woreno/Apple-II-compatible/Motherboard and other boards.png

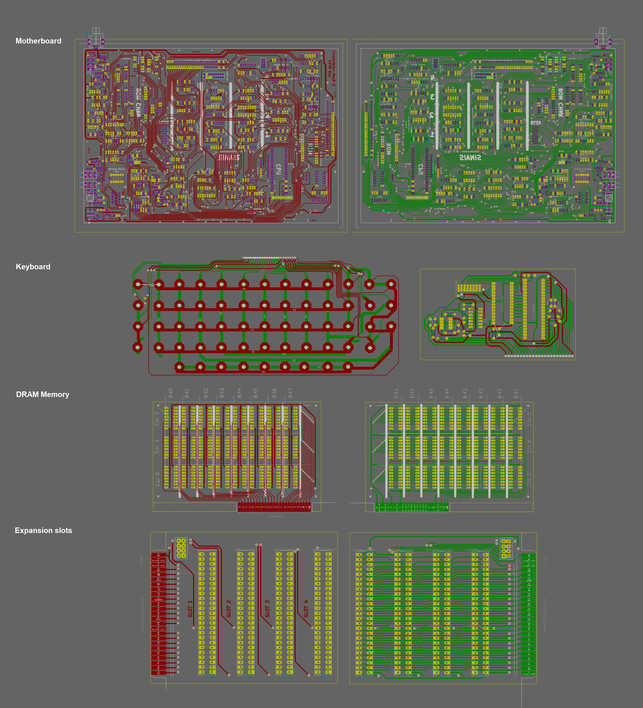
Motherboard and other boards.png
