woreno/Apple-II-compatible/KICAD/appleii-slots/appleii-slots.kicad_pcb

## KiCad design KICAD/appleii-slots/appleii-slots.kicad_pcb (2026-11-09)

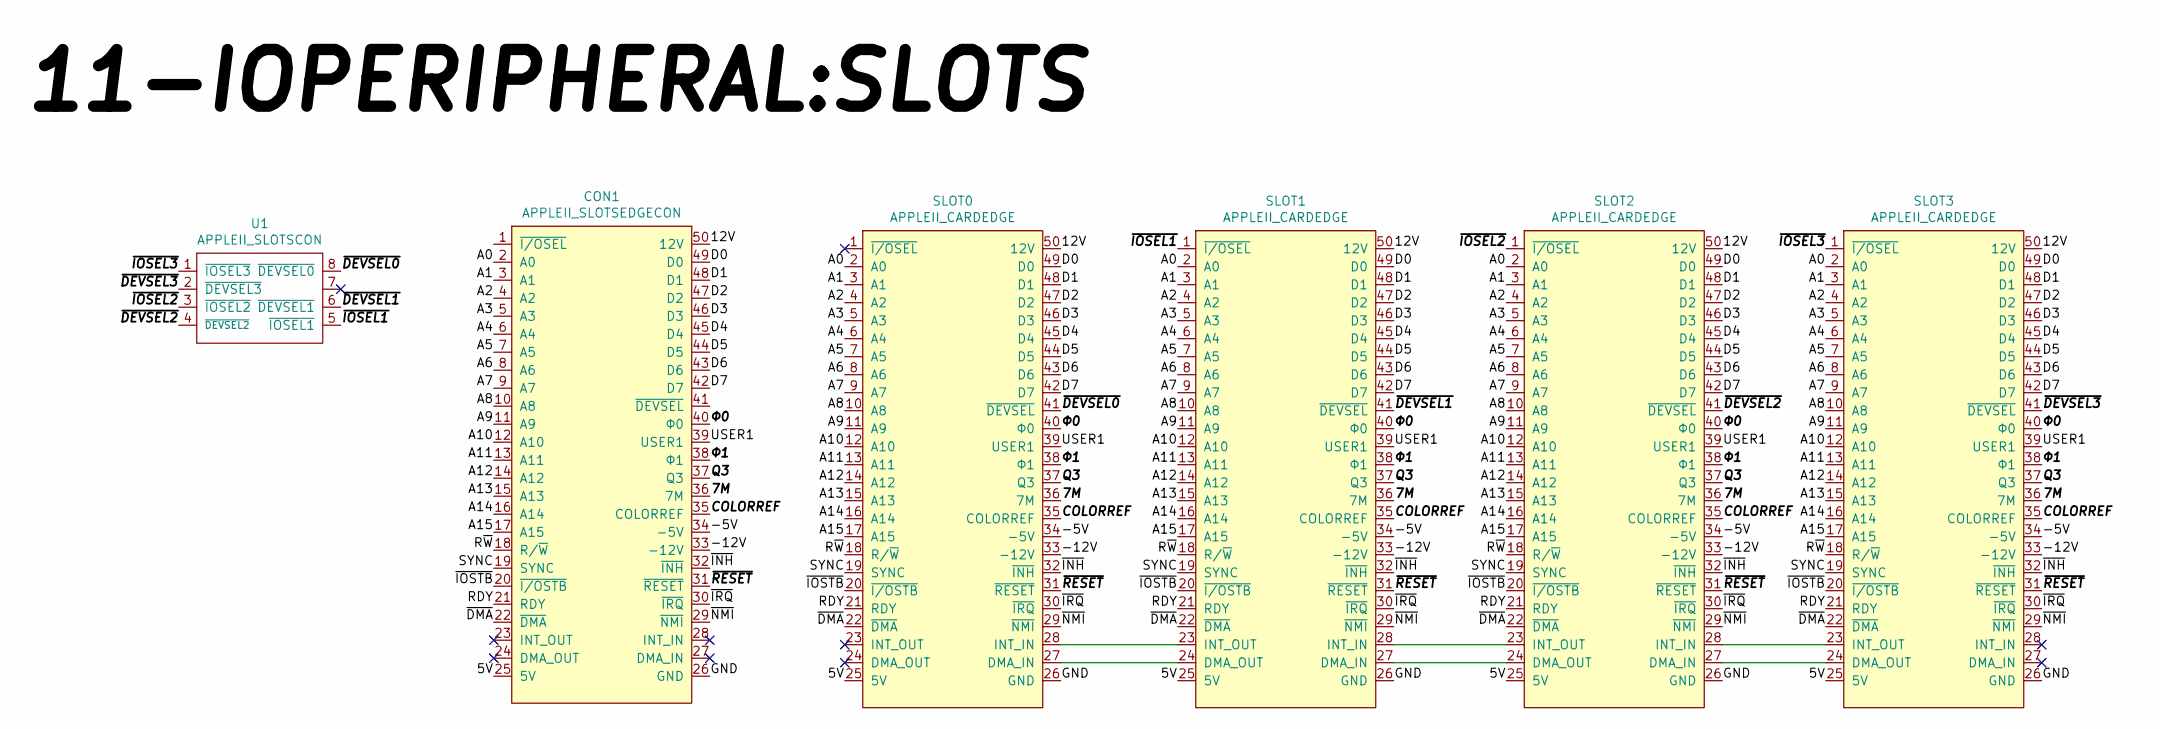
[picture p2: schematic appleii-slots.sch]

Parts:
CON1: APPLEII_SLOTSEDGECON; Apple_8bit_edge
SLOT0, SLOT1, SLOT2, SLOT3: APPLEII_CARDEDGE; Conector2x25_Oval_tinny
U1: APPLEII_SLOTSCON; conetor_2x04_P2.54

Connections:
/5V: CON1.25 (5V), SLOT0.25 (5V), SLOT1.25 (5V), SLOT2.25 (5V), SLOT3.25 (5V)
/7M: CON1.36 (7M), SLOT0.36 (7M), SLOT1.36 (7M), SLOT2.36 (7M), SLOT3.36 (7M)
/12V: CON1.50 (12V), SLOT0.50 (12V), SLOT1.50 (12V), SLOT2.50 (12V), SLOT3.50 (12V)
/-5V: CON1.34 (-5V), SLOT0.34 (-5V), SLOT1.34 (-5V), SLOT2.34 (-5V), SLOT3.34 (-5V)
/-12V: CON1.33 (-12V), SLOT0.33 (-12V), SLOT1.33 (-12V), SLOT2.33 (-12V), SLOT3.33 (-12V)
/A0: CON1.2 (A0), SLOT0.2 (A0), SLOT1.2 (A0), SLOT2.2 (A0), SLOT3.2 (A0)
/A1: CON1.3 (A1), SLOT0.3 (A1), SLOT1.3 (A1), SLOT2.3 (A1), SLOT3.3 (A1)
/A2: CON1.4 (A2), SLOT0.4 (A2), SLOT1.4 (A2), SLOT2.4 (A2), SLOT3.4 (A2)
/A3: CON1.5 (A3), SLOT0.5 (A3), SLOT1.5 (A3), SLOT2.5 (A3), SLOT3.5 (A3)
/A4: CON1.6 (A4), SLOT0.6 (A4), SLOT1.6 (A4), SLOT2.6 (A4), SLOT3.6 (A4)
/A5: CON1.7 (A5), SLOT0.7 (A5), SLOT1.7 (A5), SLOT2.7 (A5), SLOT3.7 (A5)
/A6: CON1.8 (A6), SLOT0.8 (A6), SLOT1.8 (A6), SLOT2.8 (A6), SLOT3.8 (A6)
/A7: CON1.9 (A7), SLOT0.9 (A7), SLOT1.9 (A7), SLOT2.9 (A7), SLOT3.9 (A7)
/A8: CON1.10 (A8), SLOT0.10 (A8), SLOT1.10 (A8), SLOT2.10 (A8), SLOT3.10 (A8)
/A9: CON1.11 (A9), SLOT0.11 (A9), SLOT1.11 (A9), SLOT2.11 (A9), SLOT3.11 (A9)
/A10: CON1.12 (A10), SLOT0.12 (A10), SLOT1.12 (A10), SLOT2.12 (A10), SLOT3.12 (A10)
/A11: CON1.13 (A11), SLOT0.13 (A11), SLOT1.13 (A11), SLOT2.13 (A11), SLOT3.13 (A11)
/A12: CON1.14 (A12), SLOT0.14 (A12), SLOT1.14 (A12), SLOT2.14 (A12), SLOT3.14 (A12)
/A13: CON1.15 (A13), SLOT0.15 (A13), SLOT1.15 (A13), SLOT2.15 (A13), SLOT3.15 (A13)
/A14: CON1.16 (A14), SLOT0.16 (A14), SLOT1.16 (A14), SLOT2.16 (A14), SLOT3.16 (A14)
/A15: CON1.17 (A15), SLOT0.17 (A15), SLOT1.17 (A15), SLOT2.17 (A15), SLOT3.17 (A15)
/COLORREF: CON1.35 (COLORREF), SLOT0.35 (COLORREF), SLOT1.35 (COLORREF), SLOT2.35 (COLORREF), SLOT3.35 (COLORREF)
/D0: CON1.49 (D0), SLOT0.49 (D0), SLOT1.49 (D0), SLOT2.49 (D0), SLOT3.49 (D0)
/D1: CON1.48 (D1), SLOT0.48 (D1), SLOT1.48 (D1), SLOT2.48 (D1), SLOT3.48 (D1)
/D2: CON1.47 (D2), SLOT0.47 (D2), SLOT1.47 (D2), SLOT2.47 (D2), SLOT3.47 (D2)
/D3: CON1.46 (D3), SLOT0.46 (D3), SLOT1.46 (D3), SLOT2.46 (D3), SLOT3.46 (D3)
/D4: CON1.45 (D4), SLOT0.45 (D4), SLOT1.45 (D4), SLOT2.45 (D4), SLOT3.45 (D4)
/D5: CON1.44 (D5), SLOT0.44 (D5), SLOT1.44 (D5), SLOT2.44 (D5), SLOT3.44 (D5)
/D6: CON1.43 (D6), SLOT0.43 (D6), SLOT1.43 (D6), SLOT2.43 (D6), SLOT3.43 (D6)
/D7: CON1.42 (D7), SLOT0.42 (D7), SLOT1.42 (D7), SLOT2.42 (D7), SLOT3.42 (D7)
/GND: CON1.26 (GND), SLOT0.26 (GND), SLOT1.26 (GND), SLOT2.26 (GND), SLOT3.26 (GND)
/Q3: CON1.37 (Q3), SLOT0.37 (Q3), SLOT1.37 (Q3), SLOT2.37 (Q3), SLOT3.37 (Q3)
/RDY: CON1.21 (RDY), SLOT0.21 (RDY), SLOT1.21 (RDY), SLOT2.21 (RDY), SLOT3.21 (RDY)
/R~W: CON1.18 (R/~W), SLOT0.18 (R/~W), SLOT1.18 (R/~W), SLOT2.18 (R/~W), SLOT3.18 (R/~W)
/SYNC: CON1.19 (SYNC), SLOT0.19 (SYNC), SLOT1.19 (SYNC), SLOT2.19 (SYNC), SLOT3.19 (SYNC)
/USER1: CON1.39 (USER1), SLOT0.39 (USER1), SLOT1.39 (USER1), SLOT2.39 (USER1), SLOT3.39 (USER1)
/~DEVSEL0: SLOT0.41 (~DEVSEL), U1.8 (~DEVSEL0)
/~DEVSEL1: SLOT1.41 (~DEVSEL), U1.6 (~DEVSEL1)
/~DEVSEL2: SLOT2.41 (~DEVSEL), U1.4 (~DEVSEL2)
/~DEVSEL3: SLOT3.41 (~DEVSEL), U1.2 (~DEVSEL3)
/~DMA: CON1.22 (~DMA), SLOT0.22 (~DMA), SLOT1.22 (~DMA), SLOT2.22 (~DMA), SLOT3.22 (~DMA)
/~INH: CON1.32 (~INH), SLOT0.32 (~INH), SLOT1.32 (~INH), SLOT2.32 (~INH), SLOT3.32 (~INH)
/~IOSEL1: SLOT1.1 (~I/OSEL), U1.5 (~IOSEL1)
/~IOSEL2: SLOT2.1 (~I/OSEL), U1.3 (~IOSEL2)
/~IOSEL3: SLOT3.1 (~I/OSEL), U1.1 (~IOSEL3)
/~IOSTB: CON1.20 (~I/OSTB), SLOT0.20 (~I/OSTB), SLOT1.20 (~I/OSTB), SLOT2.20 (~I/OSTB), SLOT3.20 (~I/OSTB)
/~IRQ: CON1.30 (~IRQ), SLOT0.30 (~IRQ), SLOT1.30 (~IRQ), SLOT2.30 (~IRQ), SLOT3.30 (~IRQ)
/~NMI: CON1.29 (~NMI), SLOT0.29 (~NMI), SLOT1.29 (~NMI), SLOT2.29 (~NMI), SLOT3.29 (~NMI)
/~RESET: CON1.31 (~RESET), SLOT0.31 (~RESET), SLOT1.31 (~RESET), SLOT2.31 (~RESET), SLOT3.31 (~RESET)
/Φ0: CON1.40 (Φ0), SLOT0.40 (Φ0), SLOT1.40 (Φ0), SLOT2.40 (Φ0), SLOT3.40 (Φ0)
/Φ1: CON1.38 (Φ1), SLOT0.38 (Φ1), SLOT1.38 (Φ1), SLOT2.38 (Φ1), SLOT3.38 (Φ1)
unnamed: SLOT0.27 (DMA_IN), SLOT1.24 (DMA_OUT)
unnamed: SLOT0.28 (INT_IN), SLOT1.23 (INT_OUT)
unnamed: SLOT1.27 (DMA_IN), SLOT2.24 (DMA_OUT)
unnamed: SLOT1.28 (INT_IN), SLOT2.23 (INT_OUT)
unnamed: SLOT2.27 (DMA_IN), SLOT3.24 (DMA_OUT)
unnamed: SLOT2.28 (INT_IN), SLOT3.23 (INT_OUT)

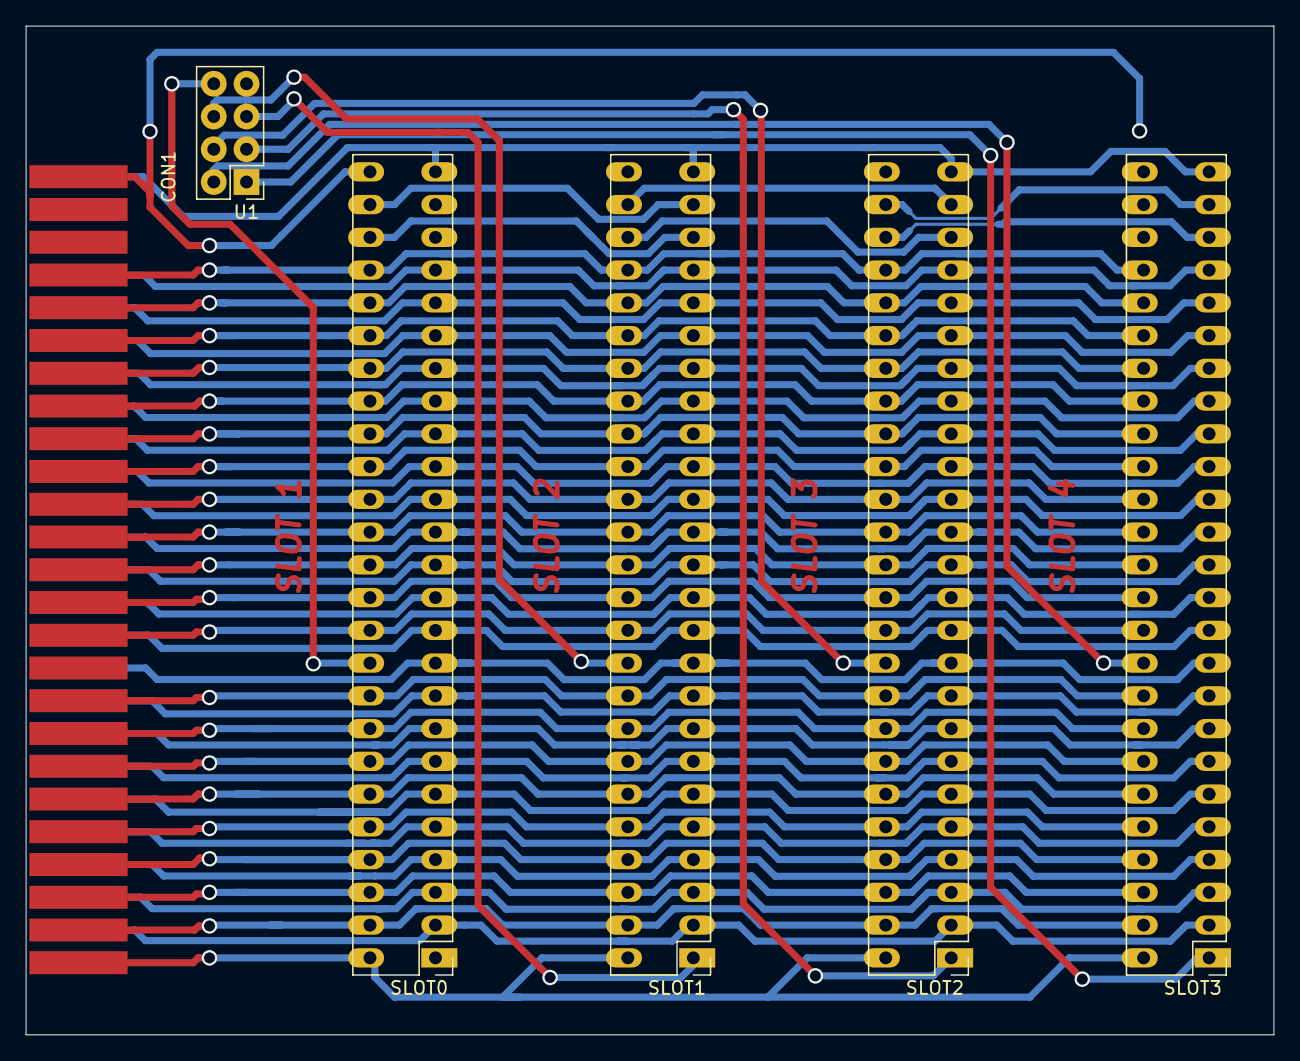
[picture p3: board appleii-slots.kicad_pcb from above]

Board: 2 copper layers, 96.8 x 78.2 mm, 6 parts (0 on the bottom side), 57 nets.
