woreno/Apple-II-compatible/KICAD/appleii-mem/appleii-mem.kicad_pcb

## KiCad design KICAD/appleii-mem/appleii-mem.kicad_pcb (2026-11-09)

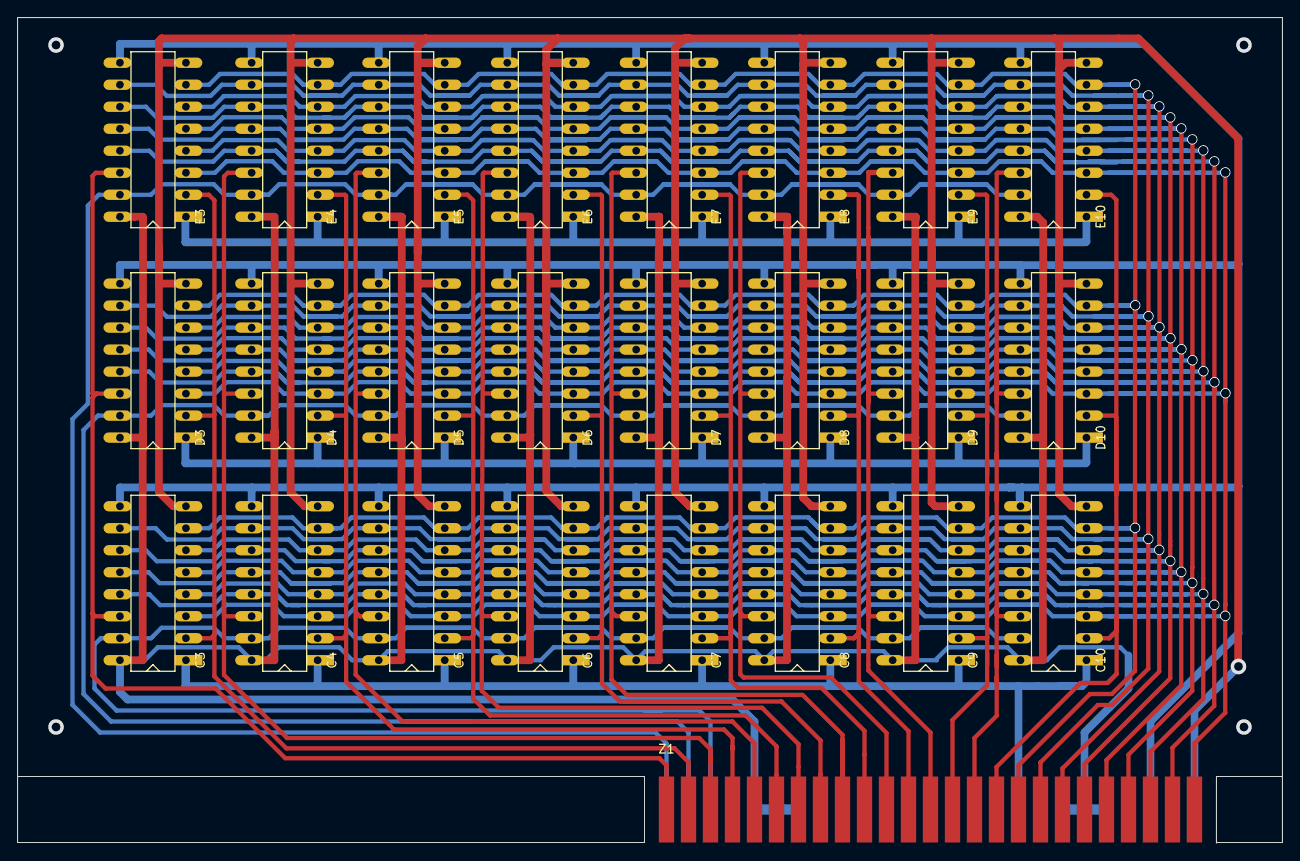
[picture p4: board appleii-mem.kicad_pcb from above]

Board: 2 copper layers, 146.0 x 95.3 mm, 25 parts (0 on the bottom side), 32 nets.

Parts:
C3, C4, C5, C6, C7, C8, C9, C10: DRAM_4116_2KB_DIP16; standard_DIP_16OvalPins
D3, D4, D5, D6, D7, D8, D9, D10: DRAM_4116_2KB_DIP16; standard_DIP_16OvalPins
E3, E4, E5, E6, E7, E8, E9, E10: DRAM_4116_2KB_DIP16; standard_DIP_16OvalPins
Z1: APPLEII_MEMCON; Apple_8bit_edge

Connections:
/5V: C3.9, C4.9, C5.9, C6.9, C7.9, C8.9, C9.9, C10.9, D3.9, D4.9, D5.9, D6.9, D7.9, D8.9, D9.9, D10.9, E3.9, E4.9, E5.9, E6.9, E7.9, E8.9, E9.9, E10.9, Z1.3
/12V: C3.8, C4.8, C5.8, C6.8, C7.8, C8.8, C9.8, C10.8, D3.8, D4.8, D5.8, D6.8, D7.8, D8.8, D9.8, D10.8, E3.8, E4.8, E5.8, E6.8, E7.8, E8.8, E9.8, E10.8, Z1.1
/-5V: C3.1, C4.1, C5.1, C6.1, C7.1, C8.1, C9.1, C10.1, D3.1, D4.1, D5.1, D6.1, D7.1, D8.1, D9.1, D10.1, E3.1, E4.1, E5.1, E6.1, E7.1, E8.1, E9.1, E10.1, Z1.9
/D0: C3.2, D3.2, E3.2, Z1.27
/D1: C4.2, D4.2, E4.2, Z1.29
/D2: C5.2, D5.2, E5.2, Z1.31
/D3: C6.2, D6.2, E6.2, Z1.33
/D4: C7.2, D7.2, E7.2, Z1.35
/D5: C8.2, D8.2, E8.2, Z1.37
/D6: C9.2, D9.2, E9.2, Z1.39
/D7: C10.2, D10.2, E10.2, Z1.41
/DO0: C3.14, D3.14, E3.14, Z1.26
/DO1: C4.14, D4.14, E4.14, Z1.28
/DO2: C5.14, D5.14, E5.14, Z1.30
/DO3: C6.14, D6.14, E6.14, Z1.32
/DO4: C7.14, D7.14, E7.14, Z1.34
/DO5: C8.14, D8.14, E8.14, Z1.36
/DO6: C9.14, D9.14, E9.14, Z1.38
/DO7: C10.14, D10.14, E10.14, Z1.40
/GND: C3.16, C4.16, C5.16, C6.16, C7.16, C8.16, C9.16, C10.16, D3.16, D4.16, D5.16, D6.16, D7.16, D8.16, D9.16, D10.16, E3.16, E4.16, E5.16, E6.16, E7.16, E8.16, E9.16, E10.16, Z1.5, Z1.6, Z1.7, Z1.19, Z1.20, Z1.21
/RA0: C3.5, C4.5, C5.5, C6.5, C7.5, C8.5, C9.5, C10.5, D3.5, D4.5, D5.5, D6.5, D7.5, D8.5, D9.5, D10.5, E3.5, E4.5, E5.5, E6.5, E7.5, E8.5, E9.5, E10.5, Z1.46
/RA1: C3.7, C4.7, C5.7, C6.7, C7.7, C8.7, C9.7, C10.7, D3.7, D4.7, D5.7, D6.7, D7.7, D8.7, D9.7, D10.7, E3.7, E4.7, E5.7, E6.7, E7.7, E8.7, E9.7, E10.7, Z1.42
/RA2: C3.6, C4.6, C5.6, C6.6, C7.6, C8.6, C9.6, C10.6, D3.6, D4.6, D5.6, D6.6, D7.6, D8.6, D9.6, D10.6, E3.6, E4.6, E5.6, E6.6, E7.6, E8.6, E9.6, E10.6, Z1.44
/RA3: C3.12, C4.12, C5.12, C6.12, C7.12, C8.12, C9.12, C10.12, D3.12, D4.12, D5.12, D6.12, D7.12, D8.12, D9.12, D10.12, E3.12, E4.12, E5.12, E6.12, E7.12, E8.12, E9.12, E10.12, Z1.47
/RA4: C3.11, C4.11, C5.11, C6.11, C7.11, C8.11, C9.11, C10.11, D3.11, D4.11, D5.11, D6.11, D7.11, D8.11, D9.11, D10.11, E3.11, E4.11, E5.11, E6.11, E7.11, E8.11, E9.11, E10.11, Z1.45
/RA5: C3.10, C4.10, C5.10, C6.10, C7.10, C8.10, C9.10, C10.10, D3.10, D4.10, D5.10, D6.10, D7.10, D8.10, D9.10, D10.10, E3.10, E4.10, E5.10, E6.10, E7.10, E8.10, E9.10, E10.10, Z1.43
/RA6: C3.13, C4.13, C5.13, C6.13, C7.13, C8.13, C9.13, C10.13, D3.13, D4.13, D5.13, D6.13, D7.13, D8.13, D9.13, D10.13, E3.13, E4.13, E5.13, E6.13, E7.13, E8.13, E9.13, E10.13, Z1.49
/~CAS_C: C3.15, C4.15, C5.15, C6.15, C7.15, C8.15, C9.15, C10.15, Z1.23
/~CAS_D: D3.15, D4.15, D5.15, D6.15, D7.15, D8.15, D9.15, D10.15, Z1.24
/~CAS_E: E3.15, E4.15, E5.15, E6.15, E7.15, E8.15, E9.15, E10.15, Z1.25
/~MEMWR: C3.3, C4.3, C5.3, C6.3, C7.3, C8.3, C9.3, C10.3, D3.3, D4.3, D5.3, D6.3, D7.3, D8.3, D9.3, D10.3, E3.3, E4.3, E5.3, E6.3, E7.3, E8.3, E9.3, E10.3, Z1.50
/~RAS: C3.4, C4.4, C5.4, C6.4, C7.4, C8.4, C9.4, C10.4, D3.4, D4.4, D5.4, D6.4, D7.4, D8.4, D9.4, D10.4, E3.4, E4.4, E5.4, E6.4, E7.4, E8.4, E9.4, E10.4, Z1.48
