woreno/Apple-II-compatible/KICAD/appleii-sram/appleii-sram.kicad_pcb

## KiCad design KICAD/appleii-sram/appleii-sram.kicad_pcb (2026-11-09)

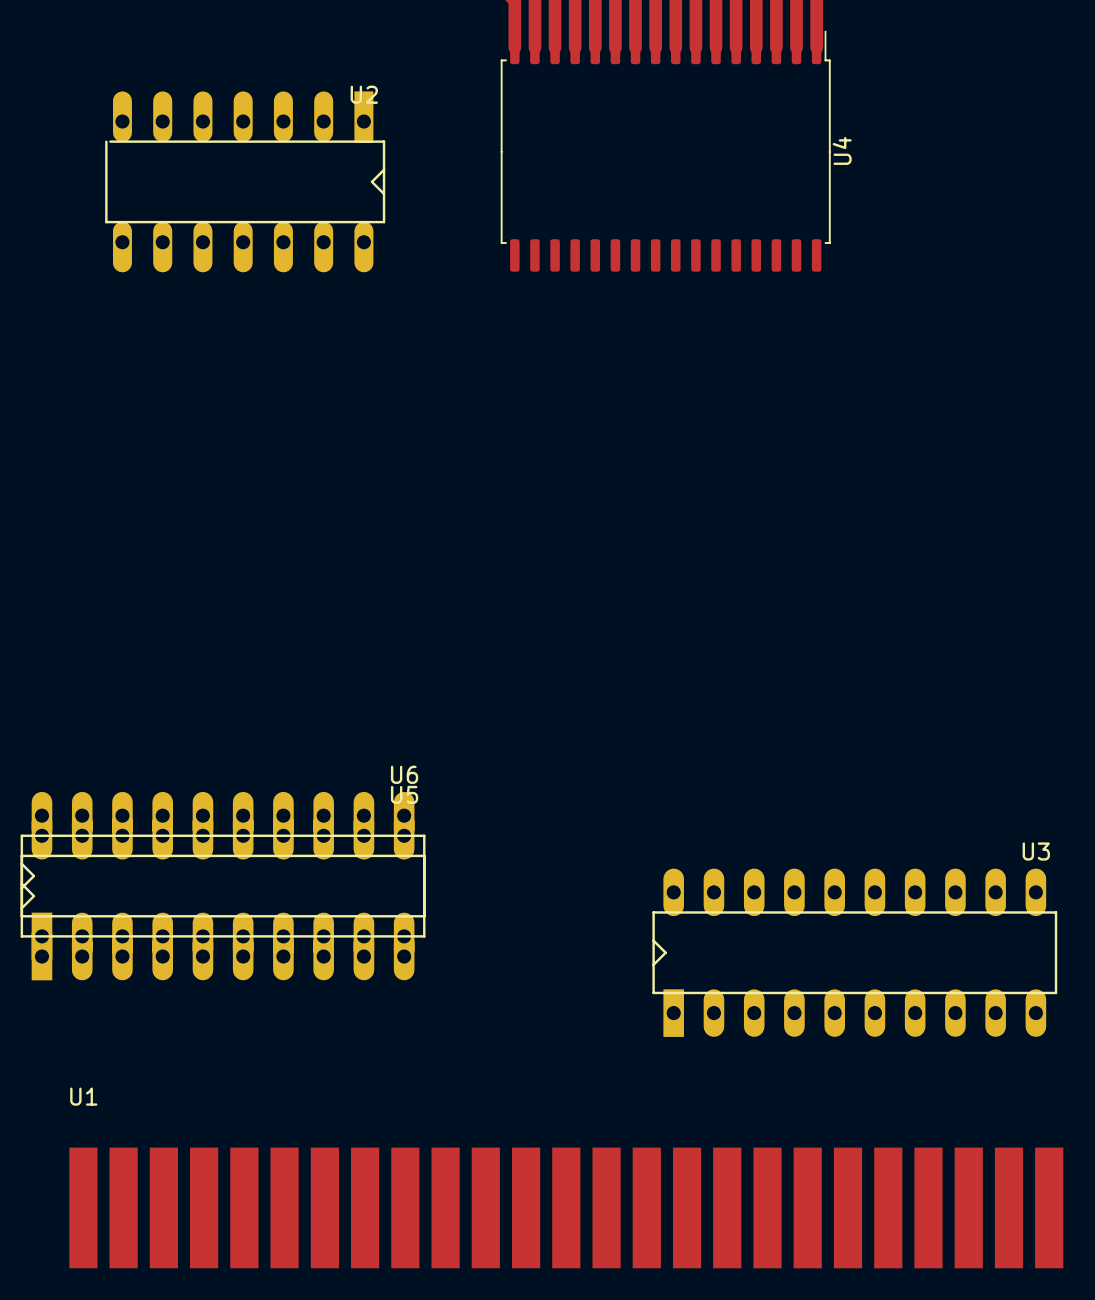
[picture p5: board appleii-sram.kicad_pcb from above]

Board: 2 copper layers, 6 parts (0 on the bottom side), 47 nets.

Parts:
U1: APPLEII_MEMCON; Apple_8bit_edge
U2: 74LS04; standard_DIP_14OvalPins
U3: 74LS574; standard_DIP_20pins_thin_body
U4: AS6C4008-55PCN; SSOP-32_11.305x20.495mm_P1.27mm
U5, U6: 74LS245; standard_DIP_20pins_thin_body

Connections:
/A0: U1.2, U3.3, U4.5
/A0': U3.18, U4.12
/A1: U1.3, U3.4, U4.27
/A1': U3.17, U4.11
/A2: U1.4, U3.5, U4.26
/A2': U3.16, U4.10
/A3: U1.5, U3.6, U4.23
/A3': U3.15, U4.9
/A4: U1.6, U3.7, U4.25
/A4': U3.14, U4.8
/A5: U1.7, U3.8, U4.4
/A5': U3.13, U4.7
/A6: U1.8, U3.9, U4.28
/A6': U3.12, U4.6
/D0: U1.49, U6.2
/D0': U4.13, U5.18, U6.18
/D1: U1.48, U6.3
/D1': U4.14, U5.17, U6.17
/D2: U1.47, U6.4
/D2': U4.15, U5.16, U6.16
/D3: U1.46, U6.5
/D3': U4.17, U5.15, U6.15
/D4: U1.45, U6.6
/D4': U4.18, U5.14, U6.14
/D5: U1.44, U6.7
/D5': U4.19, U5.13, U6.13
/D6: U1.43, U6.8
/D6': U4.20, U5.12, U6.12
/D7: U1.42, U6.9
/D7': U4.21, U5.11, U6.11
/Do0: U1.9, U5.2
/Do1: U1.10, U5.3
/Do2: U1.11, U5.4
/Do3: U1.12, U5.5
/Do4: U1.13, U5.6
/Do5: U1.14, U5.7
/Do6: U1.15, U5.8
/Do7: U1.16, U5.9
/GND: U1.26, U3.10, U4.1, U4.16, U4.22, U4.24, U4.30, U6.1, U6.10
/RAS: U2.2, U3.11
/VCC: U1.25, U3.20, U4.32, U5.20
/WRITE: U2.12, U5.19
/~CAS0: U1.20, U4.3
/~CAS1: U1.21, U4.31
/~CAS2: U1.22, U4.2
/~RAS: U1.19, U2.1
/~WRITE: U1.18, U2.13, U4.29, U6.19
