woreno/Apple-II-compatible/KICAD/appleii.kicad_pcb

## KiCad design KICAD/appleii.kicad_pcb (2026-11-09)

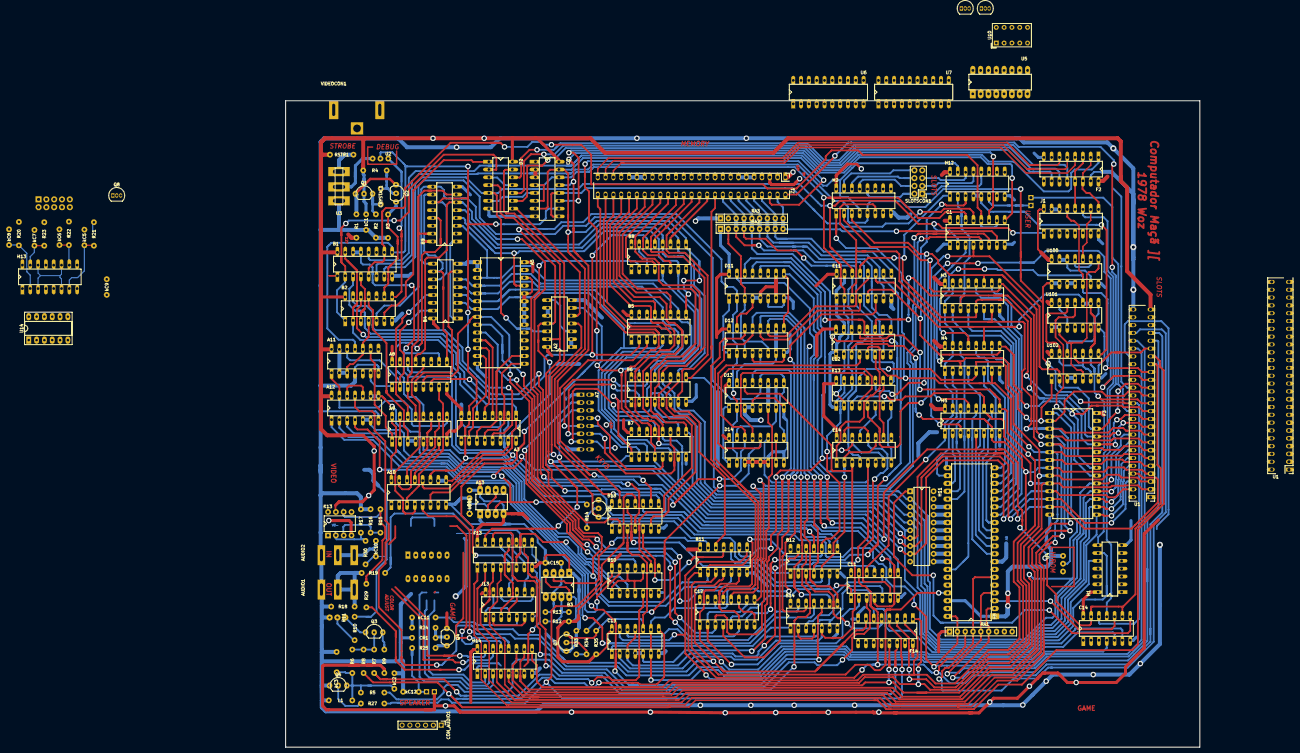
[picture p6: board appleii.kicad_pcb from above]

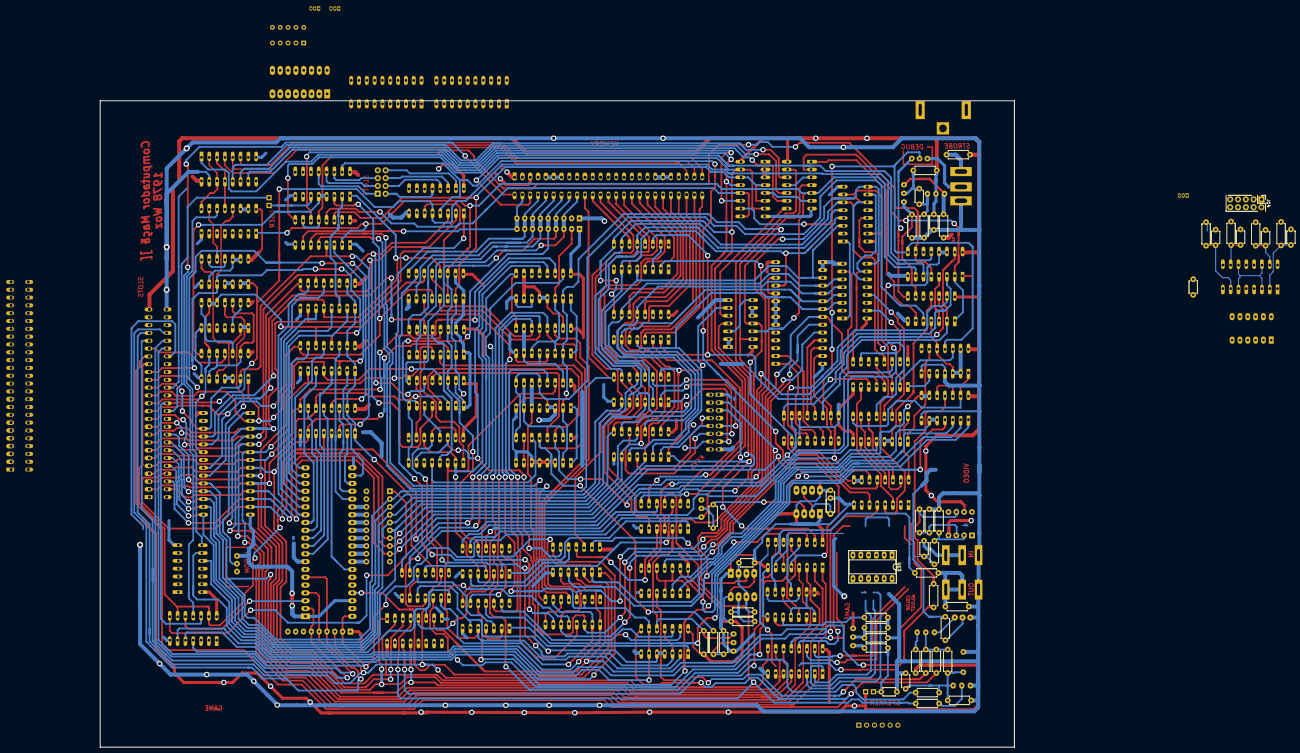
[picture p7: board appleii.kicad_pcb from below]

Board: 2 copper layers, 297.0 x 210.0 mm, 141 parts (2 on the bottom side), 324 nets.

Parts:
A2: 74LS00; standard_DIP_14OvalPins
A3: 74LS166; standard_DIP_16OvalPins
A5: PPROM_28C65_256; standard_DIP_28pins_thin_doubleBody
A7: APPLEII_KEYBCON; Conector2x8_Oval
A8: 74LS257_RD; standard_DIP_16OvalPins
A9: 74LS151; standard_DIP_16OvalPins
A10: 74LS194; standard_DIP_16OvalPins
A11: 74LS74; standard_DIP_14OvalPins
A12: 74LS02; standard_DIP_14OvalPins
A13: 555; standard_DIP_8pins
AUDIO1, AUDIO2: TS; TS - mono jack MJ3502N
B1: 74_175; standard_DIP_16OvalPins
B2: 74LS86; standard_DIP_14OvalPins
B3: 555; standard_DIP_8pins
B4, B9: 74LS194; standard_DIP_16OvalPins
B5, B8: 74LS174; standard_DIP_16OvalPins
B6, B7: 74LS257_RD; standard_DIP_16OvalPins
B10: 74LS74; standard_DIP_14OvalPins
B11: 74LS08; standard_DIP_14OvalPins
B12: 74LS11; standard_DIP_14OvalPins
B13, B14: 74LS02; standard_DIP_14OvalPins
C1: 74_153; standard_DIP_16OvalPins
C2: 74S195; standard_DIP_16OvalPins
C11: 74LS04; standard_DIP_14OvalPins
C12: 74_257; standard_DIP_16OvalPins
C13: 74LS51; standard_DIP_14OvalPins
C14: 74LS32; standard_DIP_14OvalPins
CON_AUDIO1: Conn_01x06_Female; PinHeader_1x06_P2.54mm_Vertical
CR1: 1N914; standard_2pins
CRYSTAL1: 14.31818M; standard_2pins_half
D2: 74LS20; standard_DIP_14OvalPins
D11, D12, D13, D14: 74LS161; standard_DIP_16OvalPins
E11, E12, E13: 74LS153; standard_DIP_16OvalPins
E14: 74LS283; standard_DIP_16OvalPins
F2: 74LS139; standard_DIP_16OvalPins
F3: PPROM_28C65_256; standard_DIP_28pins_thin_doubleBody
F13: 74LS138; standard_DIP_16OvalPins
F14: 74LS259; standard_DIP_16OvalPins
H1: 74LS08; standard_DIP_14OvalPins
H2, H12: 74LS138; standard_DIP_16OvalPins
H3, H4, H5: 8T97_HEXBUF; standard_DIP_16OvalPins
H8: CPU_6502; standard_DIP_40pins_doubleBody
H11: 74LS245; standard_DIP_20pins
H13: 558; standard_DIP_16OvalPins
H14: 74LS251; standard_DIP_16OvalPins
J1: 74_257; standard_DIP_16OvalPins
J13: 74LS74; standard_DIP_14OvalPins
J14: APPLEII_GAMECON; conetor_2x05_P2.54_toDB9
JP1: Jumper; jumper_set_1
K13: OpAmp_741; LM386
L1: 27u; standard_2pins
Q1, Q2: 2N3906; TO-92_Inline
Q3, Q5, Q6, Q7, Q8, Q9, Q10: 2N3904; TO-92_Inline
Q4: MPSA13; TO-92_Inline
R1: 330; standard_2pins
R2, R4: 47; standard_2pins
R3: 150; standard_2pins
R5, R14: 1K; standard_2pins
R6: 2.7K; standard_2pins
R7, R35: 1.5K; standard_2pins
R8, R33, R34: 2K; standard_2pins
R9: 10; standard_2pins
R10, R25: 27; standard_2pins
R11: 200; trimpot - 3 pin standard
R12, R16, R17, R19, R29, R30: 12K; standard_2pins
R13: 3.3M; standard_2pins
R15: 1M; standard_2pins
R18, R20, R21, R22, R23: 100; standard_2pins
R24: 47K; standard_2pins
R26: 2.2M; standard_2pins
R27: 4.7K; standard_2pins
RA1, RA2, RA3: 1K; R_Array_SIP9
RSTR1: R; standard_2pins
SLOTSCON1: APPLEII_SLOTSCON; conetor_2x04_P2.54
SPK1: 8; jumper_set_1
U1, U1#2: APPLEII_CARDEDGE; Conector2x25_Oval_0.65_rightangle
U2: manual_clock_onoff; mini_flipswitch2.54
U3: manual_clock_strobe; flipSwitch3
U4: flipSwitch; mini_flipswitch2.54
U5: 74LS175; standard_DIP_16Pins
U6, U7: 74LS244; standard_DIP_20pins_thin_body
U10: HDSP-7503; HDSP-A151
U13, U14: APPLEII_DIGITAL_GAMEPAD_FEMALE; DIP-12_W7.62mm_Socket_LongPads
U100, U101: 74LS00; standard_DIP_14OvalPins
U102: 74LS32; standard_DIP_14OvalPins
VIDEOCON1: COMP. VIDEO OUT; RCA-phono jack
Z1: APPLEII_MEMCON; Conector2x25_Oval_0.65_rightangle
kC1, kC4, kC9, kC10, kC12, kC15: 0.1u; standard_2pins_half
kC2: 47p; standard_2pins_half
kC3: 5-50p; standard_small_cap_trimmer
kC5, kC6, kC7, kC8: 22n; standard_2pins_half
kC11: 0.1u; standard_2pins

Connections:
/5V: A2.14, A3.16, A5.28, A7.1, A8.16, A9.16, A10.16, A11.14, A12.14, A13.4, A13.8, B1.16, B2.14, B3.4, B3.8, B4.16, B5.16, B7.16, B8.16, B9.16, B10.14, B11.14, B12.14, B13.14, B14.14, C1.16, C2.16, C11.14, C12.16, C13.14, C14.14, D2.14, D11.16, D12.16, D13.16, D14.16, E12.16, E13.16, E14.16, F2.16, F3.28, F13.16, F14.16, H1.14, H2.16, H12.16, H13.5, H13.13, H14.16, J1.16, J13.14, J14.2, K13.7, Q1.2, R4.2, R9.1, R12.1, R26.1, R35.2, RA1.1, RA2.1, RSTR1.2, U1.25, U1#2.25, U5.16, U13.6, U14.6, U100.14, U101.14, U102.14, Z1.3, kC1.1
/7M: A3.6, B1.15, B2.2, U1.36, U1#2.36
/12V: R1.1, Z1.1
/14M: A3.7, A10.11, A11.11, B1.9, B4.11, B9.11, B10.3, C2.10, U2.2
/14M_OUT: B2.8, U2.3
/-5V: K13.4, Z1.9
/A0: E13.3, F3.10, F14.13, H5.11, H14.11, U1.2, U1#2.2
/A1: E13.13, F3.9, F14.1, H4.5, H14.10, U1.3, U1#2.3
/A2: E12.3, F3.8, F14.2, H5.7, H14.9, U1.4, U1#2.4
/A3: E12.13, F3.7, F14.3, H5.9, U1.5, U1#2.5
/A4: E12.5, F3.6, F13.1, H2.1, H4.7, U1.6, U1#2.6
/A5: E13.5, F3.5, F13.2, H2.2, H3.9, U1.7, U1#2.7
/A6: E13.11, F3.4, F13.3, H2.3, H3.11, U1.8, U1#2.8
/A7: E11.3, F3.3, F13.4, H2.6, H3.7, U1.9, U1#2.9
/A8: E11.13, F3.25, H3.5, H12.1, U1.10, U1#2.10
/A9: E12.11, F3.24, H3.3, H12.2, U1.11, U1#2.11
/A10: E11.5, F3.21, H4.9, H12.3, U1.12, U1#2.12
/A11: E11.11, F3.23, H4.11, U1.13, U1#2.13, U101.9, U101.10, U102.9
/A12: C1.3, F3.2, H4.3, U1.14, U1#2.14, U102.1
/A13: C1.4, F3.26, H5.3, U1.15, U1#2.15, U102.2
/A14: H5.13, J1.10, U1.16, U1#2.16, U100.10
/A15: H4.13, J1.13, U1.17, U1#2.17, U100.5
/AX: C1.14, C2.4, C2.6, C2.14, E11.2, E12.2, E13.2
/AXCAS: A2.13, B12.11, B13.10, D2.4
/B4_Q0: A8.2, A11.12, B4.15
/B9_Q0: A8.3, A9.13, B9.7, B9.15
/BLANKING: A10.5, C14.6
/CASSETE_DIGITAL_INPUT: CON_AUDIO1.4, CON_AUDIO1.5, R29.2
/CASSETE_OUT_CLK: F13.13, J13.11, Q10.2
/CLRSTB: A12.2, C11.4
/COLORBURST: L1.1, Q6.3, R5.1, R6.2, kC2.1, kC3.1
/COLORREF: B1.3, B13.2, U1.35, U1#2.35
/CON_CPU_OUT: CON_AUDIO1.3, J13.9, R19.1
/CON_SPK: CON_AUDIO1.1, CON_AUDIO1.2, J13.5, kC11.2
/D0: B7.4, F3.11, H11.9, U1.49, U1#2.49, Z1.27
/D1: B7.7, F3.12, H11.8, U1.48, U1#2.48, Z1.29
/D2: B7.12, F3.13, H11.7, U1.47, U1#2.47, Z1.31
/D3: B7.9, F3.15, H11.6, U1.46, U1#2.46, Z1.33
/D4: B6.4, F3.16, H11.5, U1.45, U1#2.45, Z1.35
/D5: B6.12, F3.17, H11.4, U1.44, U1#2.44, Z1.37
/D6: B6.7, F3.18, H11.3, U1.43, U1#2.43, Z1.39
/D7: B6.9, F3.19, H11.2, H14.5, U1.42, U1#2.42, Z1.41
/DO0: B5.4, Z1.26
/DO1: B5.6, Z1.28
/DO2: B5.13, Z1.30
/DO3: B5.11, Z1.32
/DO4: B8.4, Z1.34
/DO5: B8.6, Z1.36
/DO6: B8.13, U5.12, Z1.38
/DO7: B8.11, Z1.40
/FROM_LATCHB8_Q0: A12.8, A12.9, B8.2, B11.5
/GAME_OUT0: H13.1, H14.15, U13.1, U14.1
/GAME_OUT1: H13.8, H14.12, U13.2, U14.2
/GAME_OUT2: H13.9, H14.13, U13.7, U14.7
/GAME_OUT3: H13.16, H14.14, U13.8, U14.8
/GAME_RESET_TIMERS: F13.7, H13.3, H13.6, H13.11, H13.14, U13.3, U14.3
/GAME_SW0: H14.3, J14.7, U13.10, U14.10
/GAME_SW1: H14.2, J14.1, U13.11, U14.11
/GAME_SW2: H14.1, J14.6, U13.12, U14.12
/GAME_TIM0: H13.2, R20.1, kC8.1
/GAME_TIM1: H13.7, R21.1, kC5.1
/GAME_TIM2: H13.10, R22.1, kC6.1
/GAME_TIM3: H13.15, R23.1, kC7.1
/GND: A2.1, A2.2, A2.7, A2.9, A2.10, A3.3, A3.8, A3.14, A5.1, A5.2, A5.14, A5.20, A5.21, A5.22, A5.23, A5.24, A5.26, A7.8, A8.8, A8.15, A9.8, A10.8, A11.4, A11.7, A12.7, A13.1, AUDIO1.S, AUDIO2.S, B1.8, B2.7, B2.10, B3.1, B4.8, B5.8, B6.8, B7.8, B8.8, B9.8, B10.7, B11.7, B12.7, B13.7, B14.7, C1.1, C1.8, C1.15, C2.2, C2.3, C2.8, C11.7, C12.8, C12.11, C12.15, C13.7, C14.7, CR1.2, D2.7, D11.6, D11.8, D12.4, D12.8, D13.3, D13.4, D13.8, D14.3, D14.4, D14.5, D14.6, D14.8, E11.1, E11.8, E11.15, E12.1, E12.8, E12.15, E13.1, E13.8, E13.15, E14.8, F2.8, F2.15, F3.14, F3.22, F13.8, F14.8, H1.7, H2.8, H3.8, H4.8, H5.8, H8.1, H8.21, H8.38, H11.10, H11.19, H12.8, H13.12, H14.8, J1.8, J1.14, J1.15, J13.7, J14.3, L1.2, Q4.1, Q5.1, Q6.1, Q7.1, Q8.1, Q9.1, Q10.1, R2.2, R3.2, R11.3, R16.2, R17.2, R18.1, R33.1, RA3.1, U1.26, U1#2.26, U3.1, U4.3, U5.8, U13.4, U14.4, U100.7, U101.7, U102.7, VIDEOCON1.2, Z1.5, Z1.6, Z1.7, Z1.19, Z1.20, Z1.21, kC1.2, kC2.2, kC3.2, kC4.2, kC5.2, kC6.2, kC7.2, kC8.2, kC9.2, kC12.2, kC15.2
/H0: A8.14, D14.14, E13.4
/H1: D14.13, E13.12
/H2: D14.12, E12.4, R34.1
/H3: B12.2, C13.3, C13.11, D14.11, E14.5
/H4: B14.5, C13.2, D13.14, E14.3
/H5: B14.6, C11.5, C13.4, C13.5, D13.13
/HBL: B12.13, C12.14, C13.6, C13.9, C14.5
/HIRES: B11.6, C12.1, H1.9
/HIRESMODE: A12.11, B11.4, F14.7
/KEY0: A7.12, B7.2
/KEY1: A7.13, B7.5
/KEY2: A7.10, B7.14
/KEY3: A7.11, B7.11
/KEY4: A7.6, B6.2
/KEY5: A7.5, B6.14
/KEY6: A7.7, B6.5
/KEY7: B6.11, B10.9
/LD0: A5.7, B4.3, B5.5, B7.3
/LD1: A5.6, B4.4, B5.7, B7.6
/LD2: A5.5, B4.5, B5.12, B7.13
/LD3: A5.4, B4.6, B5.10, B7.10
/LD4: A5.3, B6.3, B8.5, B9.3
/LD5: A5.25, B6.13, B8.7, B9.4
/LD6: B6.6, B8.12, B9.5, B11.12, U5.10
/LD7: A8.13, B6.10, B8.10, B9.6, B13.6
/LD194: A10.9, A10.10, B4.9, B9.9, B12.8
/M5V: U1.34, U1#2.34
/M12V: U1.33, U1#2.33
/MIXMODE: B12.3, F14.5
/PAGE2: C11.1, C12.5, F14.6, H1.10
/PISCA-PISCA: B3.3, B11.13, Q8.2
/PIXEL0: A3.12, A5.15
/PIXEL1: A3.11, A5.16
/PIXEL2: A3.10, A5.13
/PIXEL3: A3.5, A5.12
/PIXEL4: A3.4, A5.11
/Q3: C1.13, C2.9, C2.12, U1.37, U1#2.37
/RA0: E11.7, RA2.7, RA3.7, Z1.46
/RA1: E12.7, RA2.3, RA3.3, Z1.42
/RA2: E13.7, RA2.5, RA3.5, Z1.44
/RA3: E11.9, RA2.8, RA3.8, Z1.47
/RA4: E12.9, RA2.6, RA3.6, Z1.45
/RA5: E13.9, RA2.4, RA3.4, Z1.43
/RA6: C1.7, RA2.9, RA3.9, Z1.49
/RDY: H8.2, RA1.6, U1.21, U1#2.21
/RPULLUP_0: H12.6, JP1.2, RA1.7
/RPULLUP_1: D11.3, D12.3, D12.6, RA2.2
/R\~W: A2.4, C14.9, C14.13, H5.5, U1.18, U1#2.18
/SLOT_SELECT: U6.19, U7.19, U10.4, U10.5, U10.10
/SOFT5: A2.3, A2.8, A3.9, A5.27, A8.11, A10.1, A11.2, A11.3, A11.10, A11.13, B1.1, B2.4, B4.1, B5.1, B8.1, B9.1, B10.1, B10.4, B10.10, B10.12, C2.1, D11.1, D12.1, D13.1, D13.5, D14.1, D14.7, D14.10, E14.6, F3.27, F14.15, J13.1, J13.4, J13.10, J13.13, U4.1, U5.1
/SPK_OUT_CLK: F13.12, J13.3
/STROBE: A7.2, B10.11
/SYNC: C13.8, R8.2, U1.19, U1#2.19
/S_P1: A8.12, A10.4
/TEXTMODE: B13.11, F14.4, R27.1
/TEXT_VIDEO_SIGNAL: A9.3, A9.4, B2.11
/USER1: JP1.1, U1.39, U1#2.39
/V0: B14.9, D12.12, E11.4
/V1: B14.12, D12.11, E11.12
/V2: B12.4, C11.11, D11.14, E12.10
/V3: B11.9, D11.13, E14.7, E14.14
/V4: B11.10, B12.5, D11.12, E14.2, E14.11
/VA: A5.10, C12.3, D13.6, D13.11
/VB: A5.9, C12.6, D12.14
/VBL: B11.8, C13.13, C14.4
/VC: A5.8, A8.5, B14.8, C12.13, D12.13
/VIDEO_IS_TEXT: B5.3, B13.13
/VIDEO_SIGNAL: B10.5, R7.2
/auido_in: AUDIO2.T, kC10.2
/auido_out: AUDIO1.T, R18.2, R19.2
/gnd: U10.1, U10.7
/lA0: H5.12, H8.9
/lA1: H4.4, H8.10
/lA2: H5.6, H8.11
/lA3: H5.10, H8.12
/lA4: H4.6, H8.13
/lA5: H3.10, H8.14
/lA6: H3.12, H8.15
/lA7: H3.6, H8.16
/lA8: H3.4, H8.17
/lA9: H3.2, H8.18
/lA10: H4.10, H8.19
/lA11: H4.12, H8.20
/lA12: H4.2, H8.22
/lA13: H5.2, H8.23
/lA14: H5.14, H8.24
/lA15: H4.14, H8.25
/lD0: H8.33, H11.11
/lD1: H8.32, H11.12
/lD2: H8.31, H11.13
/lD3: H8.30, H11.14
/lD4: H8.29, H11.15
/lD5: H8.28, H11.16
/lD6: H8.27, H11.17
/lD7: H8.26, H11.18
/lR\~W: H5.4, H8.34
/lΦ0: B11.3, H8.37
/lΦ1: C14.10, H8.3
/pullup2: U10.2, U10.6, U10.8, U10.9
/~7M: A8.10, B1.13, B1.14, B12.9
/~CAS: B13.9, C2.13, F2.1
/~CAS_C: F2.4, Z1.23
/~CAS_D: F2.5, Z1.24
/~CAS_E: F2.6, Z1.25
/~CLRSTB: C11.3, F13.14
/~COLORREF: B1.2, B2.1, D2.2
/~DEVSEL: U1.41, U1#2.41
/~DEVSEL0: H2.15, U7.2
/~DEVSEL0': SLOTSCON1.8, U7.9, U7.18
/~DEVSEL1: H2.14, U7.4
/~DEVSEL1': SLOTSCON1.6, U7.7, U7.16
/~DEVSEL2: H2.13, U7.6
/~DEVSEL2': SLOTSCON1.4, U7.5, U7.14
/~DEVSEL3: H2.12, U7.8
/~DEVSEL3': SLOTSCON1.2, U7.3, U7.12
/~DEVSEL4: H2.11, U7.11
/~DEVSEL5: H2.10, U7.13
/~DEVSEL6: H2.9, U7.15
/~DEVSEL7: H2.7, U7.17
/~DMA: B11.1, C11.13, RA1.3, U1.22, U1#2.22
/~ENABLE_BUF: C11.12, H3.1, H3.15, H4.1, H4.15, H5.1, H5.15
/~ENABLE_IO: F13.5, H2.4, H12.15
/~EN_CASSETE_AND_JOY: F13.9, H14.7
/~EN_SOFTSWITCHES: F13.10, F14.14
/~H12_ENABLE: H12.4, H12.5, U102.8
/~HPE: B2.5, D13.9, D13.12, D14.9
/~INH: U1.32, U1#2.32
/~IOSEL0': SLOTSCON1.7, U6.9, U6.18
/~IOSEL1: H12.14, U6.4
/~IOSEL1': SLOTSCON1.5, U6.7, U6.16
/~IOSEL2: H12.13, U6.6
/~IOSEL2': SLOTSCON1.3, U6.5, U6.14
/~IOSEL3: H12.12, U6.8
/~IOSEL3': SLOTSCON1.1, U6.3, U6.12
/~IOSEL4: H12.11, U6.11
/~IOSEL5: H12.10, U6.13
/~IOSEL6: H12.9, U6.15
/~IOSEL7: H12.7, U6.17
/~IOSTB: U1.20, U1#2.20, U102.11
/~IRQ: H8.4, RA1.5, U1.30, U1#2.30
/~KBD: B6.1, B7.1, D2.13, F13.15
/~LPDS: A2.11, A3.15, D11.2, D12.2, D13.2, D14.2
/~MEMWR: C14.11, Z1.50
/~NMI: H8.6, RA1.4, U1.29, U1#2.29
/~PAGE2: C11.2, C12.2, C12.10
/~Q3: C1.11, C2.11
/~RAMSEL: A2.6, B6.15, B7.15
/~RAS: B5.9, B8.9, B13.8, C2.7, C2.15, U5.9, Z1.48
/~RESET: A7.3, H8.40, Q5.3, RA1.2, U1.31, U1#2.31
/~ROM_CS: F3.20, U101.11
/~SLOT_SELECT: U6.1, U7.1, U10.3
/~TEXT: A8.6, B5.2, B8.14
/Σ0: E12.12, E14.4
/Σ1: E12.6, E14.1
/Σ2: E13.6, E14.13
/Σ3: E13.10, E14.10
/Φ0: A2.12, B1.7, B11.2, B12.10, C1.2, D2.5, E11.14, E12.14, E13.14, F13.6, J1.1, U1.40, U1#2.40
/Φ1: B1.6, C14.12, H2.5, U1.38, U1#2.38, U100.1, U100.2
unnamed: A2.5, D2.8
unnamed: A3.13, B2.13
unnamed: A8.4, B4.7
unnamed: A8.9, B4.10, B9.10
unnamed: A9.5, B10.2
unnamed: A9.12, B9.13
unnamed: A9.14, B4.13
unnamed: A9.2, A9.15
unnamed: A8.7, A10.3
unnamed: A3.2, A10.6, B13.4
unnamed: A3.1, A10.12, B2.12
unnamed: A9.7, A10.13
unnamed: A9.11, A10.14
unnamed: A9.10, A10.15
unnamed: A9.9, A11.1, A12.13
unnamed: A8.1, A11.6
unnamed: A9.1, A11.9
unnamed: A12.1, B10.13
unnamed: A12.3, A13.3, R14.2
unnamed: A12.4, B14.11
unnamed: A12.5, A12.6, B14.10
unnamed: A12.10, A12.12
unnamed: A13.2, A13.6, R26.2, kC4.1
unnamed: B1.4, B2.3
unnamed: B1.5, B1.10, C1.10, C1.12
unnamed: B1.12, C1.9
unnamed: B2.6, D2.1
unnamed: B2.9, Q2.3, R3.1
unnamed: B3.2, B3.6, R13.2, kC15.1
unnamed: B3.7, R12.2, R13.1
unnamed: B8.3, B8.15
unnamed: B11.11, B13.5
unnamed: B12.1, B13.1
unnamed: B12.6, B13.12
unnamed: B12.12, R5.2
unnamed: B13.3, C13.10, Q7.3, R35.1
unnamed: B14.1, C13.1
unnamed: B14.2, B14.4
unnamed: B14.3, C11.10
unnamed: B14.13, C13.12
unnamed: C1.5, C12.12
unnamed: C1.6, C12.9
unnamed: C2.5, D2.6
unnamed: C11.6, E14.12, E14.15
unnamed: C11.8, D11.9, D12.9
unnamed: C11.9, D11.15
unnamed: C12.4, E11.6
unnamed: C12.7, E11.10
unnamed: C14.8, H11.1
unnamed: CR1.1, Q4.2, R24.1
unnamed: CRYSTAL1.1, Q1.3, R2.1
unnamed: CRYSTAL1.2, Q2.2, R4.1
unnamed: D2.9, F2.10
unnamed: D2.10, F2.11
unnamed: D2.12, F2.12
unnamed: D11.4, D11.5, D11.7, D11.10, D12.15
unnamed: D12.5, D12.7, D12.10, D13.15
unnamed: D13.7, D13.10, D14.15
unnamed: F2.3, F2.13, J1.12
unnamed: F2.2, F2.14, J1.9
unnamed: F3.1, U4.2
unnamed: H1.8, J1.11
unnamed: H13.4, kC9.1
unnamed: J13.2, J13.6
unnamed: J13.8, J13.12
unnamed: J14.4, R22.2
unnamed: J14.5, R20.2
unnamed: J14.8, R21.2
unnamed: J14.9, R23.2
unnamed: K13.2, R17.1, R30.1
unnamed: K13.3, R15.1, R16.1
unnamed: K13.6, R15.2, R29.1
unnamed: Q1.1, Q2.1, R1.2
unnamed: Q3.1, R11.1
unnamed: Q3.2, R6.1, R7.1, R8.1
unnamed: Q3.3, R9.2
unnamed: Q4.3, R25.2
unnamed: Q5.2, R14.1
unnamed: Q6.2, R27.2
unnamed: Q7.2, R33.2, R34.2
unnamed: Q9.3, Q10.3
unnamed: R10.1, VIDEOCON1.1
unnamed: R10.2, R11.2
unnamed: R24.2, kC11.1
unnamed: R25.1, SPK1.2, kC12.1
unnamed: R30.2, kC10.1
unnamed: RSTR1.1, U3.3
unnamed: U1.1, U1#2.1
unnamed: U1.23, U1#2.23
unnamed: U1.24, U1#2.24
unnamed: U1.27, U1#2.27
unnamed: U1.28, U1#2.28
unnamed: U1.50, U1#2.50
unnamed: U2.1, U3.2
unnamed: U100.3, U100.4
unnamed: U100.8, U101.1, U101.2, U102.5
unnamed: U100.9, U100.11
unnamed: U100.6, U100.12, U100.13
unnamed: U101.8, U102.12
unnamed: U101.12, U102.6, U102.10, U102.13
unnamed: U101.3, U101.13
unnamed: U102.3, U102.4
