woreno/Apple-II-compatible/KICAD/appleii-keyb/appleii-keyb.kicad_pcb

## KiCad design KICAD/appleii-keyb/appleii-keyb.kicad_pcb (2026-11-09)

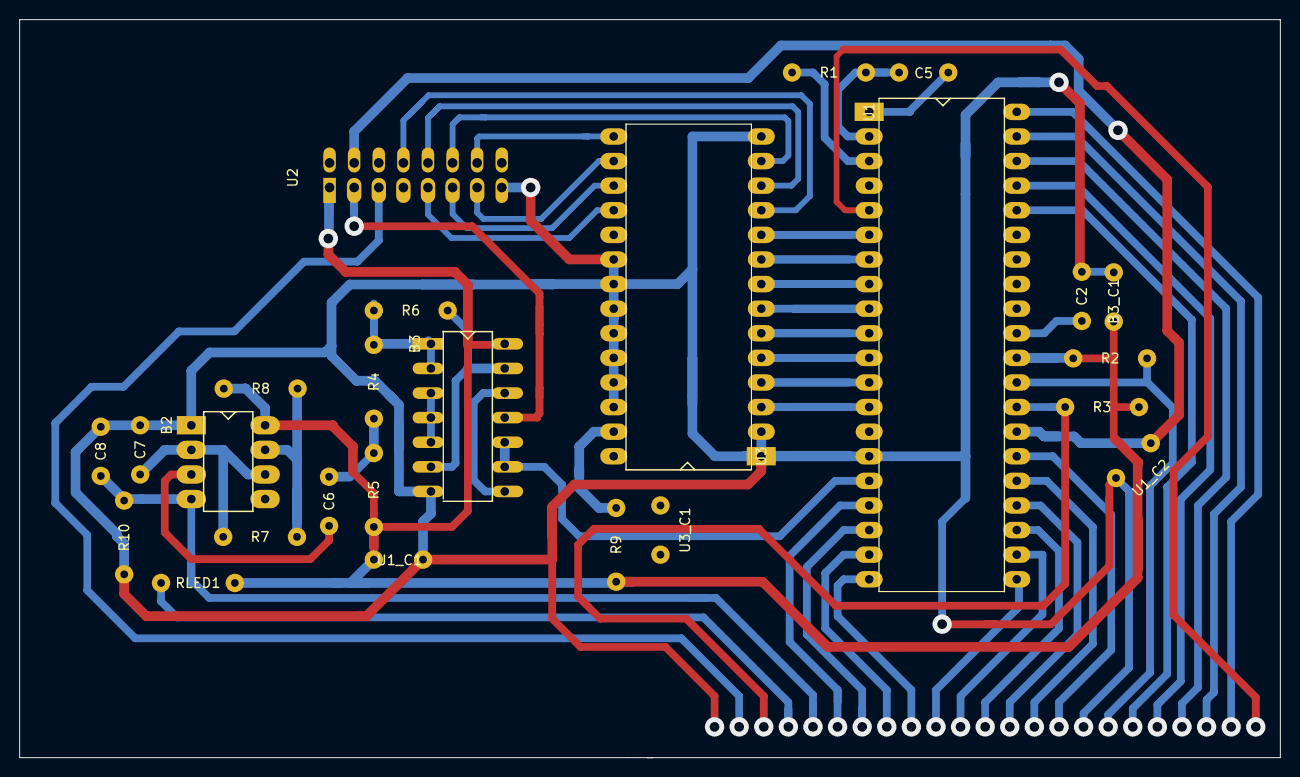
[picture p8: board appleii-keyb.kicad_pcb from above]

Board: 2 copper layers, 130.2 x 76.2 mm, 25 parts (0 on the bottom side), 36 nets.

Parts:
B2: 555; standard_DIP_8pins
B3: 74LS00; standard_DIP_14OvalPins
B3_C1: 0.1u; standard_2pins_half
C2: 22nF; standard_2pins_half
C5: 47pF; standard_2pins_half
C6, C7, C8: 0.1u; standard_2pins_half
R1: 51K; standard_2pins
R2, R3, R5, R6, R9: 4.7K; standard_2pins
R4: 220; standard_2pins
R7: 220K; standard_2pins
R8: 510K; standard_2pins
R10: 3K; standard_2pins
RLED1: 250; standard_2pins
U1: AY-5-3600-PRO; standard_DIP_40pins_doubleBody
U1_C1, U1_C2, U3_C1: 0.1u; standard_2pins_half
U2: APPLEII_KEYBCON; Conector2x8_Oval
U3: PPROM_28C65_256; standard_DIP_28pins_doubleBody

Connections:
/5V: B2.8, B3.14, B3_C1.1, R2.1, R3.1, R5.2, R8.1, R9.1, RLED1.1, U1.30, U1_C1.2, U2.1, U3.28, U3_C1.1
/-12V: U1.27, U1_C2.1, U2.15
/ASCII_0: U2.12, U3.12
/ASCII_1: U2.13, U3.11
/ASCII_2: U2.10, U3.15
/ASCII_3: U2.11, U3.13
/ASCII_4: U2.6, U3.17
/ASCII_5: U2.5, U3.18
/ASCII_6: U2.7, U3.16
/CTRL_KEY: R3.2, U1.28
/DATA_READY: B3.9, B3.10, U1.16
/GND: B2.1, B3.7, B3_C1.2, C2.2, C7.2, C8.2, R10.2, U1.15, U1_C1.1, U1_C2.2, U2.8, U3.1, U3.2, U3.14, U3.20, U3.21, U3.22, U3.23, U3.24, U3.25, U3.26, U3_C1.2
/REP_KEY: B2.4, C8.1, R10.1
/SCAN_D0: U1.6, U3.10
/SCAN_D1: U1.7, U3.9
/SCAN_D2: U1.8, U3.8
/SCAN_D3: U1.9, U3.7
/SCAN_D4: U1.10, U3.6
/SCAN_D5: U1.11, U3.5
/SCAN_D6: U1.12, U3.4
/SCAN_D7: U1.13, U3.3
/SHIFT_KEY: R2.2, U1.29
/STROBE: B3.11, U2.2
unnamed: B2.2, B2.6, C7.1, R7.2
unnamed: B2.3, C6.1
unnamed: B2.7, R7.1, R8.2
unnamed: B3.1, B3.2, R4.1, R6.2
unnamed: B3.3, B3.4, B3.5
unnamed: B3.8, B3.12
unnamed: B3.6, B3.13, R6.1
unnamed: C2.1, U1.31
unnamed: C5.1, R1.1, U1.2
unnamed: C5.2, U1.1
unnamed: C6.2, R4.2, R5.1
unnamed: R1.2, U1.3
unnamed: R9.2, U3.27
